fitu/CAD_TEST/outputs/assembly_open.step

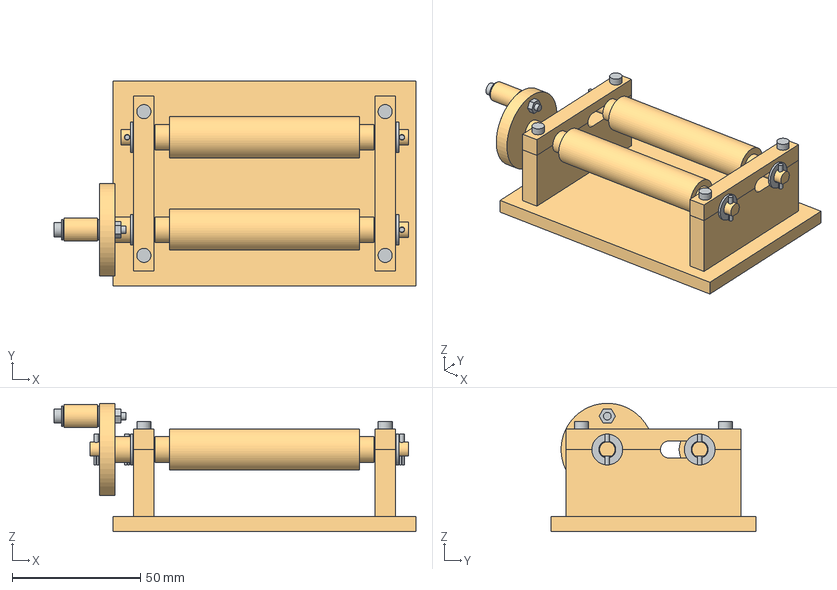
[picture p2: CAD file, 2026-10-28]
outputs/assembly_open.step
141.0 x 80.0 x 50.0 mm
hw_left_front_M3x40_bolt
hw_left_front_M3_nut
hw_left_rear_M3x40_bolt
hw_left_rear_M3_nut
left_bearing_cap
hw_right_front_M3x40_bolt
hw_right_front_M3_nut
hw_right_rear_M3x40_bolt
hw_right_rear_M3_nut
right_bearing_cap
frame
drive_drum
hw_left_drive_2x12_split_pin
hw_right_drive_2x12_split_pin
drive_shaft
left_drive_spacer
hw_left_drive_M6_washer
right_drive_spacer
hw_right_drive_M6_washer
follower_drum
hw_left_follower_2x12_split_pin
hw_right_follower_2x12_split_pin
follower_shaft
left_follower_spacer
hw_left_follower_M6_washer
right_follower_spacer
hw_right_follower_M6_washer
handwheel
wheel_spacer
crank_sleeve
crank_grip
hw_crank_outer_M3_washer
hw_crank_inner_M3_washer
hw_crank_M3x25_bolt
hw_crank_M3_nut
