fitu/CAD_TEST/outputs/apron_cutting_template.step

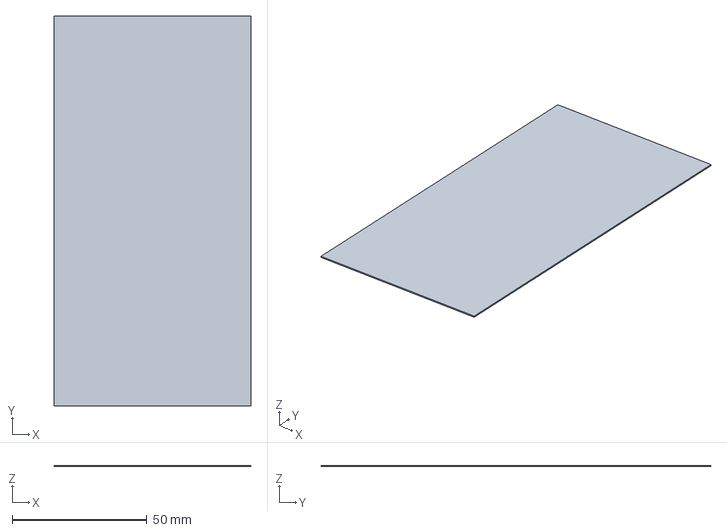
[picture p4: CAD file, 2026-10-28]
outputs/apron_cutting_template.step
73.0 x 144.5 x 0.5 mm
