fitu/CAD_TEST/outputs/stl/reference/flexible_apron_reference.stl

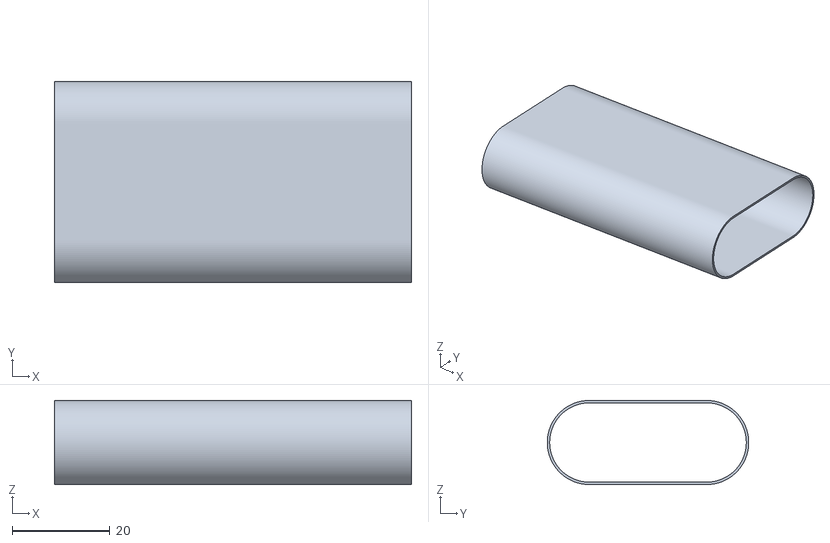
[picture p5: CAD file, 2026-10-28]
outputs/stl/reference/flexible_apron_reference.stl
73.0 x 41.2 x 17.2
