fitu/CAD_TEST/outputs/hw_left_drive_2x12_split_pin.step

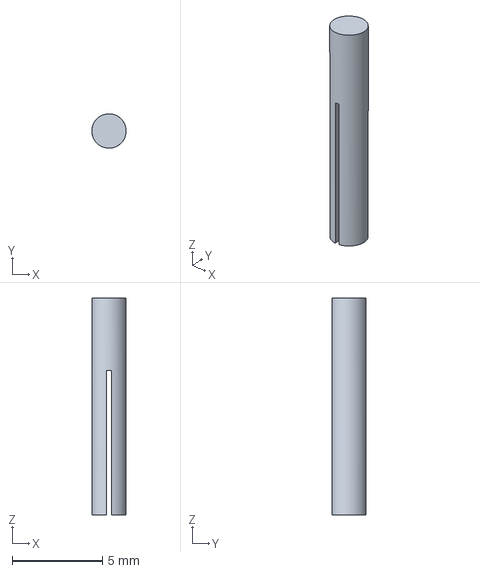
[picture p6: CAD file, 2026-10-28]
outputs/hw_left_drive_2x12_split_pin.step
1.90 x 1.90 x 12.0 mm
