fitu/CAD_TEST/outputs/left_bearing_cap.step

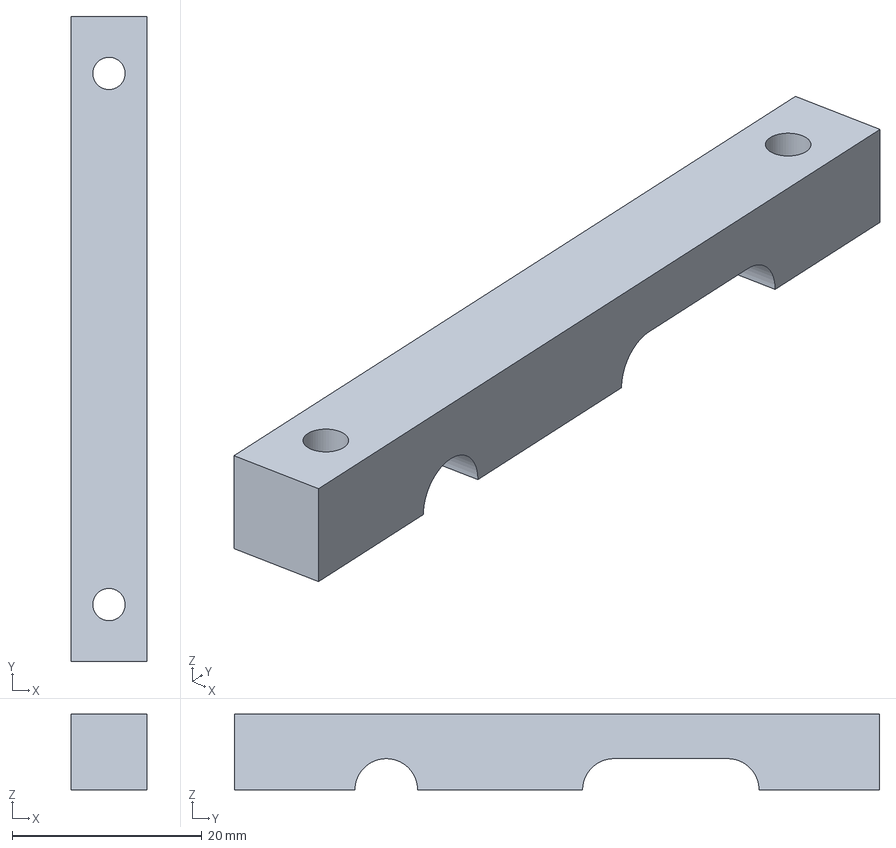
[picture p7: CAD file, 2026-10-28]
outputs/left_bearing_cap.step
8.00 x 68.0 x 8.00 mm
