fitu/CAD_TEST/outputs/right_follower_spacer.step

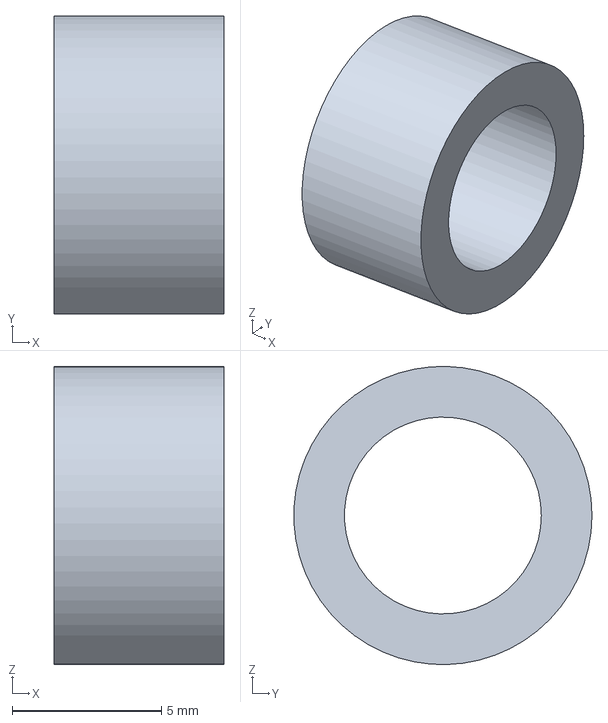
[picture p8: CAD file, 2026-10-28]
outputs/right_follower_spacer.step
5.70 x 9.99 x 10.00 mm
