fitu/CAD_TEST/outputs/follower_shaft.step

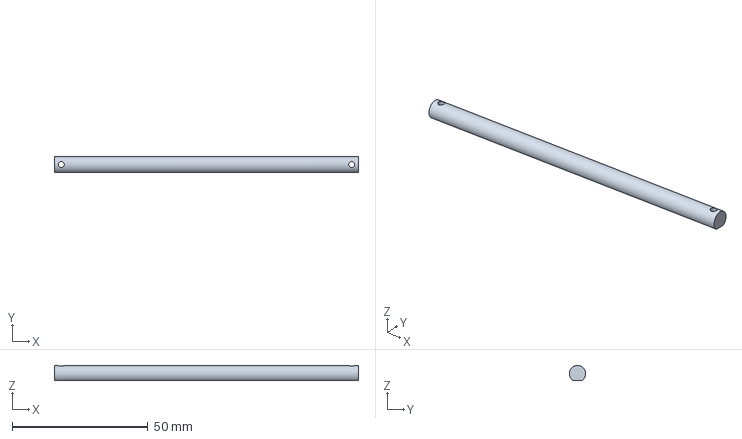
[picture p9: CAD file, 2026-10-28]
outputs/follower_shaft.step
112.0 x 6.00 x 5.50 mm
