fitu/CAD_TEST/outputs/follower_drum.step

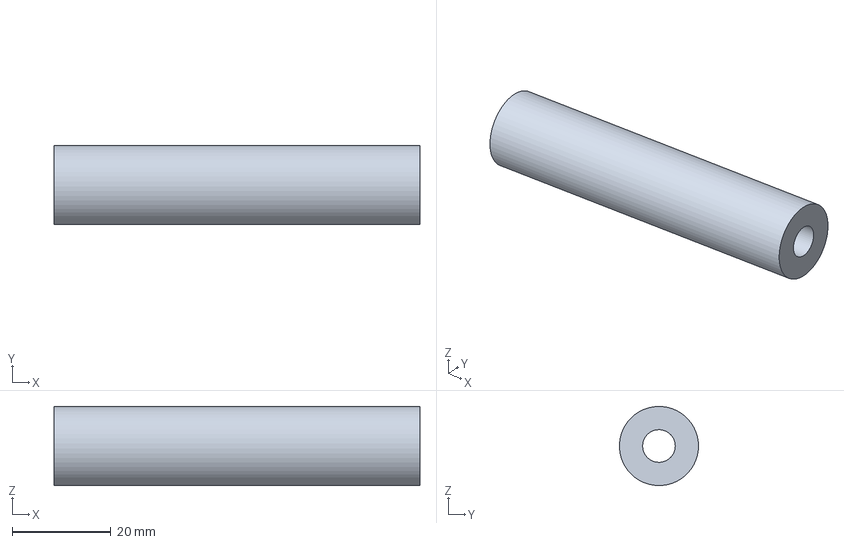
[picture p10: CAD file, 2026-10-28]
outputs/follower_drum.step
74.0 x 16.0 x 16.0 mm
