fitu/CAD_TEST/outputs/handwheel.step

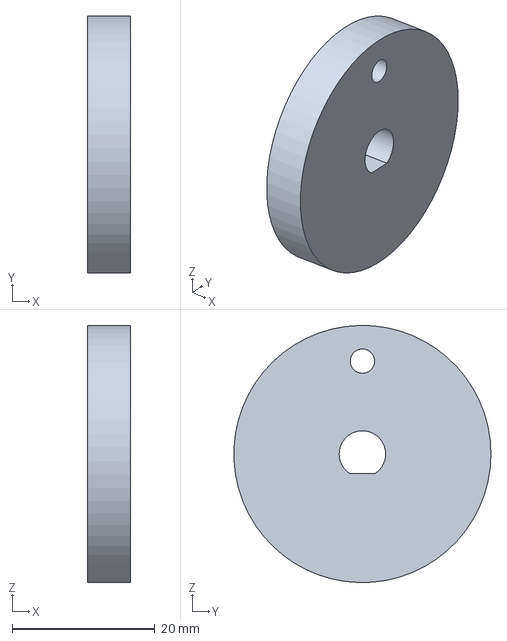
[picture p11: CAD file, 2026-10-28]
outputs/handwheel.step
6.00 x 36.0 x 36.0 mm
