fitu/CAD_TEST/outputs/crank_sleeve.step

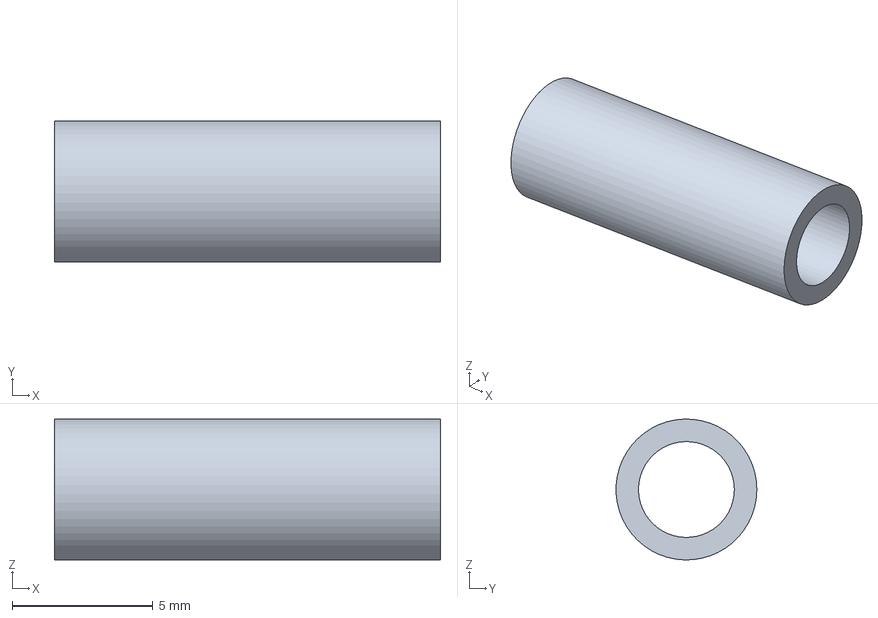
[picture p12: CAD file, 2026-10-28]
outputs/crank_sleeve.step
13.7 x 5.00 x 5.00 mm
