fitu/CAD_TEST/outputs/frame.step

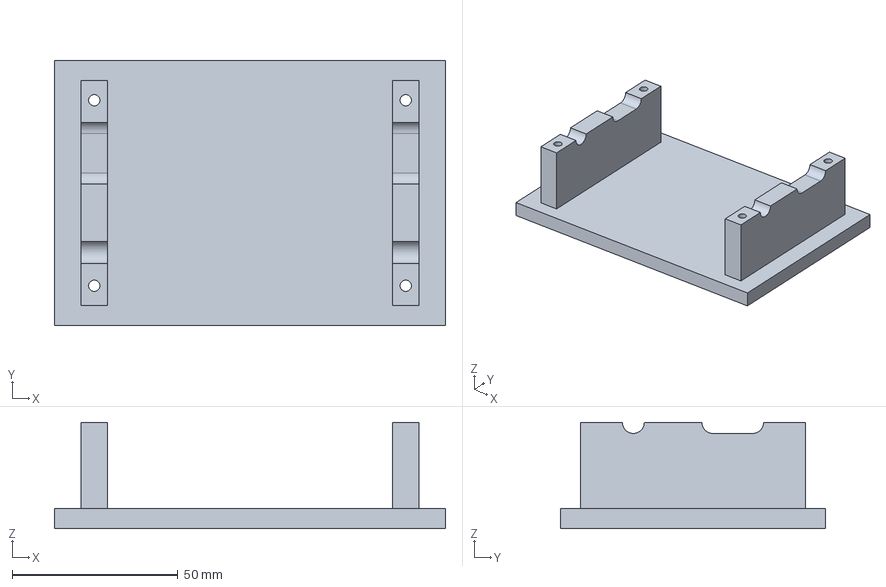
[picture p13: CAD file, 2026-10-28]
outputs/frame.step
118.0 x 80.0 x 32.0 mm
