fitu/CAD_TEST/outputs/drive_shaft.step

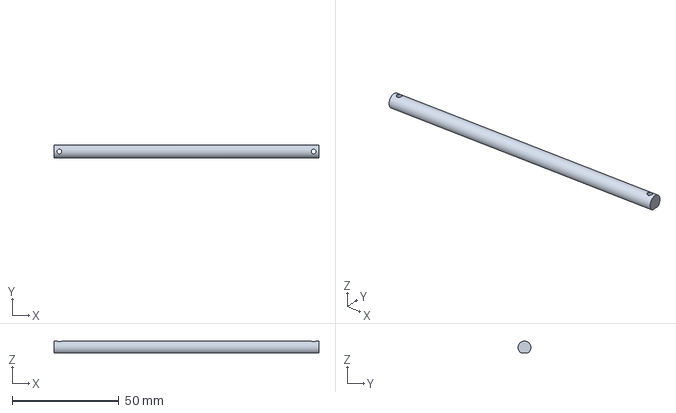
[picture p14: CAD file, 2026-10-28]
outputs/drive_shaft.step
124.0 x 6.00 x 5.50 mm
