fitu/CAD_TEST/outputs/fit_coupon.step

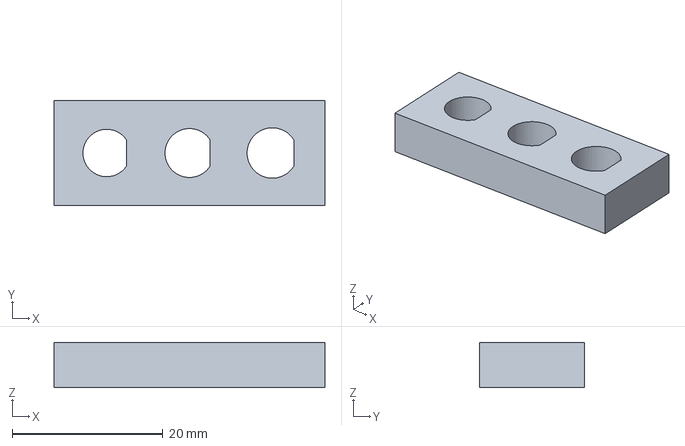
[picture p15: CAD file, 2026-10-28]
outputs/fit_coupon.step
36.0 x 14.0 x 6.00 mm
