fitu/CAD_TEST/outputs/crank_grip.step

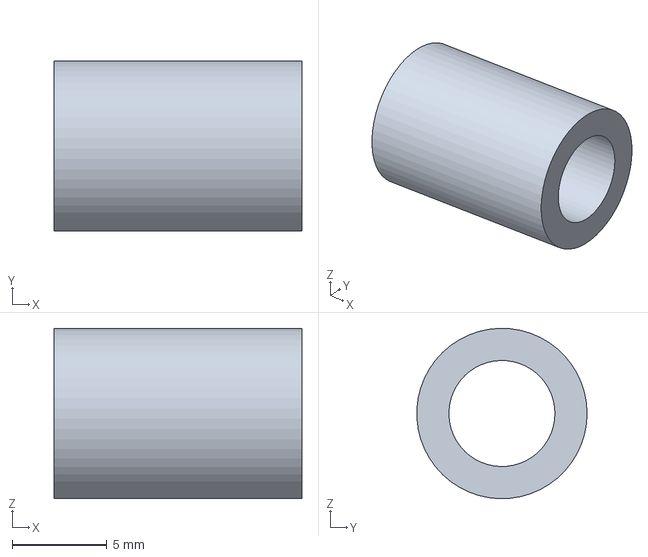
[picture p16: CAD file, 2026-10-28]
outputs/crank_grip.step
13.1 x 8.99 x 9.00 mm
