fitu/CAD_TEST/outputs/wheel_spacer.step

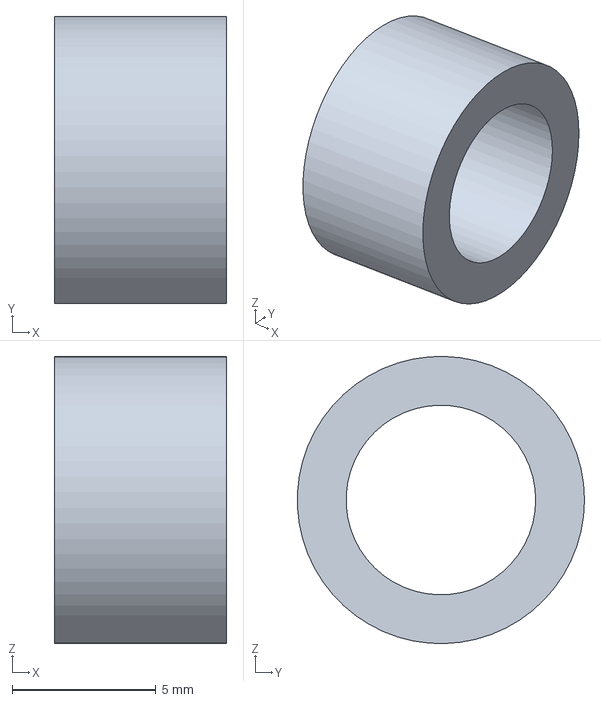
[picture p17: CAD file, 2026-10-28]
outputs/wheel_spacer.step
6.00 x 9.99 x 10.00 mm
