fitu/CAD_TEST/(list of files, cad)

Other CAD files:
outputs/stl/reference/apron_cutting_template.stl
outputs/stl/hardware/hw_left_drive_2x12_split_pin.stl
outputs/stl/hardware/hw_left_follower_2x12_split_pin.stl
outputs/drive_drum.step
outputs/stl/hardware/hw_right_follower_2x12_split_pin.stl
outputs/right_bearing_cap.step
outputs/stl/hardware/hw_right_drive_2x12_split_pin.stl
outputs/left_follower_spacer.step
outputs/right_drive_spacer.step
outputs/hw_right_follower_2x12_split_pin.step
outputs/flexible_apron_reference.step
outputs/hw_left_follower_2x12_split_pin.step
outputs/left_drive_spacer.step
outputs/hw_right_drive_2x12_split_pin.step
outputs/hw_crank_M3_nut.step
outputs/hw_crank_M3x25_bolt.step
outputs/hw_crank_inner_M3_washer.step
outputs/hw_crank_outer_M3_washer.step
outputs/hw_left_drive_M6_washer.step
outputs/hw_left_follower_M6_washer.step
outputs/hw_left_front_M3_nut.step
outputs/hw_left_front_M3x40_bolt.step
outputs/hw_left_rear_M3_nut.step
outputs/hw_left_rear_M3x40_bolt.step
outputs/hw_right_drive_M6_washer.step
outputs/hw_right_follower_M6_washer.step
outputs/hw_right_front_M3_nut.step
outputs/hw_right_front_M3x40_bolt.step
outputs/hw_right_rear_M3_nut.step
outputs/hw_right_rear_M3x40_bolt.step
outputs/stl/crank_grip.stl
outputs/stl/crank_sleeve.stl
outputs/stl/drive_drum.stl
outputs/stl/drive_shaft.stl
outputs/stl/fit_coupon.stl
outputs/stl/follower_drum.stl
outputs/stl/follower_shaft.stl
outputs/stl/frame.stl
outputs/stl/handwheel.stl
outputs/stl/hardware/hw_crank_M3_nut.stl
outputs/stl/hardware/hw_crank_M3x25_bolt.stl
outputs/stl/hardware/hw_crank_inner_M3_washer.stl
outputs/stl/hardware/hw_crank_outer_M3_washer.stl
outputs/stl/hardware/hw_left_drive_M6_washer.stl
outputs/stl/hardware/hw_left_follower_M6_washer.stl
outputs/stl/hardware/hw_left_front_M3_nut.stl
outputs/stl/hardware/hw_left_front_M3x40_bolt.stl
outputs/stl/hardware/hw_left_rear_M3_nut.stl
outputs/stl/hardware/hw_left_rear_M3x40_bolt.stl
outputs/stl/hardware/hw_right_drive_M6_washer.stl
outputs/stl/hardware/hw_right_follower_M6_washer.stl
outputs/stl/hardware/hw_right_front_M3_nut.stl
outputs/stl/hardware/hw_right_front_M3x40_bolt.stl
outputs/stl/hardware/hw_right_rear_M3_nut.stl
outputs/stl/hardware/hw_right_rear_M3x40_bolt.stl
outputs/stl/left_bearing_cap.stl
outputs/stl/left_drive_spacer.stl
outputs/stl/left_follower_spacer.stl
outputs/stl/right_bearing_cap.stl
outputs/stl/right_drive_spacer.stl
outputs/stl/right_follower_spacer.stl
outputs/stl/wheel_spacer.stl
