fitu/CAD_TEST/(commit log)

2026-10-28 Add parametric CadQuery herbal roller concept and validated STEP exports
    [assembly.step, base.step, crank_grip.step, crank_pin.step, drive_drum.step, drive_shaft.step, flexible_apron.step, follower_drum.step]
2026-10-28 Add validated individual STL exports and slicer download bundle
    [base.stl, crank_grip.stl, crank_pin.stl, drive_drum.stl, drive_shaft.stl, flexible_apron.stl, follower_drum.stl, follower_shaft.stl]
2026-10-28 Redesign roller for axial assembly and oriented FDM printing
    [apron_cutting_template.step, apron_cutting_template.stl, assembly.step, assembly_open.step, base.step, base.stl, crank_grip.step, crank_grip.stl]
